Sarnolds18/Proyecto_2_Arqui/docs/evidencia.md

# Evidencia FPGA → ASIC (sección 3.1)

Construcciones del RTL del Proyecto 2 (tag `p2-entrega`) que dependen de la FPGA, el
mensaje de LibreLane que las evidenció y cómo se reemplazaron. Cada log citado debe
existir en el repo (corrida guardada en `flow/asic_top/runs/`).

## Corridas

| Corrida | RTL | Resultado |
|---|---|---|
| `00_rtl_p2_sin_cambios` | Tag `p2-entrega` + `rtl/asic_top.v` | Se detiene en la etapa 3 de 80 (`Checker.LintErrors`): 2 errores de lint (`flow.log:7`, `error.log:1`) |
| `01_regfile_ff` | `00` + register file de flip-flops (#1 resuelto) | Corrida con `--to OpenROAD.STAPrePNR` (etapas 1–12): lint y síntesis pasan sin errores. Ningún mensaje de error por #2–#5: Yosys los acepta y descarta los valores iniciales en silencio (ver detalle) |
| `02_reset_externo` | `01` + reset externo, `debounce_bank` con reset, 7-seg activo alto (#4, #5, #7) + SDC propio | `--to OpenROAD.STAPrePNR`: lint sin `PROCASSINIT` ni `rst_ni` sin usar; en síntesis el único valor inicial que queda es el de la RAM (`06-yosys-synthesis/yosys-synthesis.log:1085`, punto 2) |

| # | Construcción | Archivo | Mensaje de LibreLane (log:línea) | Reemplazo |
|---|---|---|---|---|
| 1 | Primitiva `SB_RAM40_4K` (iCE40) | `rtl/espino_core/espino_register_file.v` | `flow/asic_top/runs/00_rtl_p2_sin_cambios/01-verilator-lint/verilator-lint.log:1` y `:13` (`%Error-MODMISSING`) | Banco de 15×32 flip-flops con lectura sincrónica y reset a 0 |
| 2 | `initial $readmemh` | `rtl/pochoco_ram.v` | `flow/asic_top/runs/01_regfile_ff/06-yosys-synthesis/yosys-synthesis.log:1093` (`meminit`) y `:4102`–`4106` (`DFFLEGALIZE`); sin warning | El programa queda en el circuito: ROM combinacional `game_rom` generada por `sw/assembler.py --rom` (estrategia 1) o valores de reset de los flip-flops (estrategia 2); `pochoco_ram.v` eliminado (ver `docs/memoria.md`) |
| 3 | Inferencia de BRAM (512 palabras) | `rtl/pochoco_ram.v` | `flow/asic_top/runs/01_regfile_ff/06-yosys-synthesis/yosys-synthesis.log:1401`–`1406` (`MEMORY_MAP`) y `:4532`, `:4558` (estadísticas) | Memoria dimensionada al uso real (99 palabras de instrucción, 0 de datos): `pochoco_mem_rom` (ROM + 8 palabras de datos) o `pochoco_mem_ff` (107 palabras de flip-flops) |
| 4 | Reset de encendido por valor inicial (`reg [12:0] por_cnt = 13'b0`) | `rtl/pochoco_soc.v` | `flow/asic_top/runs/01_regfile_ff/01-verilator-lint/verilator-lint.log:7` (`%Warning-PROCASSINIT`), `flow/asic_top/runs/01_regfile_ff/06-yosys-synthesis/yosys-synthesis.log:304`–`305` (`PROC_INIT`) y `:4102`–`4106`; además `verilator-lint.log:1` (`rst_ni` sin usar) | Puerto `rst_ni` en `asic_top` → sincronizador de 2 FF en `pochoco_soc` (aserción asíncrona, liberación sincrónica); `por_cnt` eliminado |
| 5 | Bloque `initial` y registros sin reset | `rtl/debouncer.v` | `flow/asic_top/runs/01_regfile_ff/06-yosys-synthesis/yosys-synthesis.log:299`–`303` (`PROC_INIT`) y `:4102`–`4106`; sin warning | Reset asíncrono a 0 en `debounce_bank`; `initial` eliminado |
| 6 | Supuesto de reloj de 25 MHz (`TICK_BITS`, constantes de `game.s`) | `rtl/debouncer.v`, `sw/game.s` | Sin mensaje (no es un error de síntesis, ver detalle) | `TICK_BITS` 18 → 17 (~13 ms a 10 MHz); constantes de `game.s` recalculadas para 10 MHz (P3-07) |
| 7 | Inversión `~seg` para displays activo-bajo de la Go Board | `rtl/pochoco_soc.v` | Sin mensaje (ver detalle) | Salidas activo alto en `pochoco_soc`/`asic_top`; la inversión queda solo en `game_top` |
| 8 | Botones asíncronos sin sincronizador | `rtl/debouncer.v` | Sin mensaje (ver detalle) | Sincronizador de 2 FF por botón dentro de `debounce_bank` |

## Detalle por construcción

Para cada fila: extracto del mensaje, explicación de por qué es un problema en ASIC y
descripción del cambio. Si una construcción no produjo ningún mensaje del flujo, se
explica por qué igual era un problema.

### 1. `SB_RAM40_4K`

Corrida `00_rtl_p2_sin_cambios`, `01-verilator-lint/verilator-lint.log`:

```
1:  %Error-MODMISSING: .../rtl/espino_core/espino_register_file.v:22:3: Cannot find file containing module: 'SB_RAM40_4K'
13: %Error-MODMISSING: .../rtl/espino_core/espino_register_file.v:33:3: Cannot find file containing module: 'SB_RAM40_4K'
16: %Error: Exiting due to 2 error(s)
```

`SB_RAM40_4K` es un bloque de RAM físico de la iCE40, instanciado directamente en el
banco de registros (dos copias para tener dos puertos de lectura). En el ASIC no existe:
la biblioteca `gf180mcu_fd_sc_mcu7t5v0` solo tiene celdas estándar y el proyecto no usa
macros SRAM. Verilator no encuentra el módulo y LibreLane detiene el flujo en
`Checker.LintErrors` antes de llegar a síntesis, por lo que esta corrida no alcanza a
mostrar las demás construcciones de la tabla.

Reemplazo: `espino_register_file` reescrito con flip-flops (mismo nombre de módulo y
puertos, instancia `u_rf` sin cambios):

- x1..x15 como 15 registros de 32 bits; x0 no se almacena y se lee como 0.
- **Lectura sincrónica**: `rdata_a_o`/`rdata_b_o` son registros, igual que la salida
  de `SB_RAM40_4K`. El core depende de esa latencia de un ciclo (FSM `ops_valid_q` en
  `espino_id_stage.v`), así que no se cambió a lectura combinacional.
- **Reset a 0** con `rst_ni`, para reproducir el `INIT_0 = 0` de las BRAM: en la FPGA
  los registros arrancaban en 0 y en ASIC los flip-flops arrancan indeterminados.
- Costo: 15×32 + 2×32 = 544 flip-flops (antes, 0 FF y 4 BRAM).

Verificación: `sim/tb_register_file.v` (reset, x0, lectura sincrónica,
read-before-write y 2000 accesos aleatorios contra un modelo de referencia) pasa, y
`sim/tb_game_smoke.v` da exactamente la misma salida y los mismos tiempos que con el
modelo `SB_RAM40_4K` de `cells_sim.v`.

### 2. `initial $readmemh`

Corrida `01_regfile_ff`, `06-yosys-synthesis/yosys-synthesis.log`:

```
1093: Removed top 23 address bits (of 32) from memory init port asic_top.$flatten\u_pochoco.\u_ram.$meminit$\mem$.../rtl/pochoco_ram.v:36$123 (u_pochoco.u_ram.mem).
4102: 155.1. Executing DFFLEGALIZE pass (convert FFs to types supported by the target).
4103: Mapping DFF cells in module `\asic_top':
4104:   mapped 738 $_DFF_PN0_ cells to \gf180mcu_fd_sc_mcu7t5v0__dffrnq_1 cells.
4105:   mapped 3 $_DFF_PN1_ cells to \gf180mcu_fd_sc_mcu7t5v0__dffsnq_1 cells.
4106:   mapped 16488 $_DFF_P_ cells to \gf180mcu_fd_sc_mcu7t5v0__dffq_1 cells.
```

Yosys sí lee `game.hex` (resuelve la ruta relativa al archivo fuente) y lo guarda como
puerto de inicialización de la memoria (`meminit`, línea 1093). Pero al convertir la
memoria a flip-flops ese contenido solo puede quedar como valor inicial de cada FF, y
las celdas de GF180 no tienen valor inicial: `DFFLEGALIZE` mapea los 16.488 FF sin reset
a `dffq_1` (línea 4106) y el contenido del programa desaparece del netlist **sin ningún
warning ni error** (`warning.log` solo tiene los avisos de lint y de SDC). En la FPGA el
bitstream carga el contenido de la BRAM al configurarse; en el silicio no hay ningún
mecanismo que lo haga, así que el SoC arrancaría ejecutando memoria indeterminada.

Reemplazo: el programa ya no se carga desde un archivo. `sw/assembler.py --rom` genera
`rtl/game_rom.v` desde `game.s`; la estrategia 1 lo usa como ROM y la 2 como valores de
reset de los flip-flops. Detalle y comparación en `docs/memoria.md`.

### 3. Inferencia de BRAM

Corrida `01_regfile_ff`, `06-yosys-synthesis/yosys-synthesis.log`:

```
1401: Mapping memory \u_pochoco.u_ram.mem in module \asic_top:
1402:   created 512 $dff cells and 0 static cells of width 32.
1405:   read interface: 2 $dff and 1022 $mux cells.
1406:   write interface: 2048 write mux blocks.
4532:     16488 1.05E+06   gf180mcu_fd_sc_mcu7t5v0__dffq_1
4558:    Chip area for module '\asic_top': 2312311.724800
4559:      of which used for sequential elements: 1104958.310400 (47.79%)
```

En la iCE40 la RAM de 512×32 se infería como bloques BRAM (0 LUT/FF). Sin macros SRAM
no hay donde inferirla: `MEMORY_MAP` la convierte en 512×32 = 16.384 flip-flops más
sus multiplexores de lectura y escritura. El diseño completo queda en 67.817 celdas y
2,31 mm² de área de celdas, casi la mitad en elementos secuenciales. No es un error del
flujo, pero el área se dispara y casi toda es memoria que el juego no usa: el
programa ocupa 99 palabras de instrucción y 0 de datos.

Reemplazo: memoria dimensionada al uso real del juego (99 palabras de instrucción y 0
de datos, contadas con `scripts/contar_palabras.py`). Ver `docs/memoria.md`.

### 4. Reset de encendido por valor inicial

Corrida `01_regfile_ff`:

```
01-verilator-lint/verilator-lint.log:
1: %Warning-UNUSEDSIGNAL: rtl/asic_top.v:22:21: Signal is not used: 'rst_ni'
7: %Warning-PROCASSINIT: rtl/pochoco_soc.v:38:25: Procedural assignment to declaration with initial value: 'por_cnt'

06-yosys-synthesis/yosys-synthesis.log:
304: Found init rule in `$paramod$...\pochoco_soc.$proc$rtl/pochoco_soc.v:38$20'.
305:   Set init value: \por_cnt = 13'0000000000000
```

Verilator avisa que `por_cnt` tiene valor inicial en la declaración y además se asigna
en un `always`. Yosys lo convierte en un atributo `init` (línea 305), que se pierde en
`DFFLEGALIZE` (líneas 4102–4106) igual que en el punto 2. En la FPGA todos los FF valen
0 después de configurar, así que `por_cnt` contaba de 0 a 4096 y soltaba el reset. En
el ASIC arranca en un valor indeterminado: si `por_cnt[12]` arranca en 1 el SoC nunca
pasa por reset, y en simulación queda en X y el reset no se suelta nunca. El warning
de la línea 1 muestra la otra cara del problema: `asic_top` tiene un puerto `rst_ni`
que todavía no llega a ningún lado.

Reemplazo:

- `asic_top` lleva su puerto `rst_ni` (asíncrono, activo bajo) a un nuevo puerto
  `i_Rst_n` de `pochoco_soc`.
- `pochoco_soc` lo pasa por un **sincronizador de 2 flip-flops**: el reset se aplica
  apenas baja `i_Rst_n` (asíncrono, no necesita reloj) y se libera dos flancos de reloj
  después de que sube, sincronizado con `clk`. Así todos los FF del SoC salen de reset
  en el mismo flanco y no hay violaciones de *recovery/removal* (la liberación de un
  reset asíncrono se comporta como una entrada de datos respecto del reloj).
- `por_cnt` se eliminó sin reemplazo de espera: los 4096 ciclos existían porque las BRAM
  de la iCE40 necesitan tiempo tras la configuración, y en el ASIC no hay BRAM.

Verificación: lint de Verilator sin `PROCASSINIT` ni `rst_ni` sin usar;
`sim/tb_game_smoke.v` (que ahora maneja `i_Rst_n`) pasa con el mismo resultado que
antes, con todos los eventos adelantados exactamente 4090 ciclos (reset de 4096 ciclos →
~6 ciclos: 4 del testbench + 2 del sincronizador). En la corrida `02_reset_externo` ya no aparece
el warning `PROCASSINIT` ni la regla `PROC_INIT` de `por_cnt`; el único valor inicial
que queda en `06-yosys-synthesis/yosys-synthesis.log` es el de la RAM (línea 1085). Como en simulación todos los FF
arrancan en X, esto también muestra que el SoC ya no depende de valores iniciales
(salvo el contenido de la RAM, punto 2).

### 5. `initial` en `debounce_bank`

Corrida `01_regfile_ff`, `06-yosys-synthesis/yosys-synthesis.log`:

```
299: Found init rule in `$paramod\debounce_bank\TICK_BITS=s32'00000000000000000000000000010010.$proc$rtl/debouncer.v:36$130'.
300:   Set init value: \btn_estable = 4'0000
301:   Set init value: \tick_cnt = 18'000000000000000000
302:   Set init value: \tick_bit_prev = 1'0
303:   Set init value: \btn_prev_sample = 4'0000
```

El bloque `initial` es la única inicialización de estos registros (no tienen reset).
Yosys lo acepta sin warning y los valores se pierden en `DFFLEGALIZE`. La consecuencia
es más leve que en el punto 4 (`tick_cnt` es de libre corrida y `btn_estable` se
corrige en el primer muestreo), pero hasta los primeros dos muestreos de `tick` el SoC puede
leer botones falsos, y en simulación del netlist los registros quedan en X.

Reemplazo: `debounce_bank` recibe `rst_ni` (el mismo reset sincronizado del SoC, vía
`pochoco_periph`) y sus cuatro registros tienen reset asíncrono a 0; el bloque
`initial` se eliminó. Verificación: `sim/tb_pochoco_periph.v` pasa.

### 6. Supuesto de reloj de 25 MHz

No produce ningún mensaje: para la síntesis un contador de 18 bits o una constante de
75.000.000 son igual de válidos. El problema es de comportamiento. El diseño corre en el
ASIC con `CLOCK_PERIOD` = 100 ns (10 MHz), no con los 25 MHz del oscilador de la Go Board,
y todo lo que mide tiempo contando ciclos queda 2,5 veces más lento:

- `debounce_bank` con `TICK_BITS=18` muestrea cada 2^18 / 10 MHz ≈ 26,2 ms (antes
  ~10,5 ms a 25 MHz).
- En `game.s`, los 3 s de espera (75.000.000 ciclos) pasarían a durar 7,5 s, y cada
  décima medida (2.500.000 ciclos) pasaría a valer 0,25 s, así que el tiempo de reacción
  mostrado quedaría mal.

Reemplazo:

- `TICK_BITS` por defecto 18 → **17** en `debounce_bank` y en `DEBOUNCE_TICK_BITS` de
  `pochoco_periph`: 2^17 / 10 MHz ≈ 13,1 ms, cerca de la ventana de ~10 ms del
  Proyecto 1.
- Constantes de `game.s` para 10 MHz (P3-07): 3 s = 30.000.000 ciclos, 2 s =
  20.000.000 y 1 décima = 1.000.000 (cálculo en la cabecera de `sw/game.s`).

### 7. Inversión de los 7 segmentos

No produce ningún mensaje: un inversor es lógica perfectamente sintetizable. El problema
es que la polaridad activo bajo es propiedad de los displays de la Go Board,
no del SoC. `asic_top` es un macro cuyas salidas son terminales lógicos, sin saber qué
display (ni qué driver) va a conectarse, así que dejar la inversión adentro fijaría una
convención de la placa en el silicio.

Reemplazo: `pochoco_soc` (y por lo tanto `asic_top`) entrega los segmentos **activo
alto**, `{G,F,E,D,C,B,A}`, tal como los produce `hex2seg`. La inversión `~seg` se movió a
`game_top`, el top de la FPGA, que es el que conoce la placa.

### 8. Botones sin sincronizador

No produce ningún mensaje: el flujo no puede saber que `btn_i` viene de un botón
mecánico, asíncrono al reloj. En el Proyecto 2 (y en el debouncer del Proyecto 1) los
botones entraban directo a la lógica de muestreo, que los comparaba y guardaba en el
mismo flanco. Si un botón cambia justo en la ventana de setup/hold de esos flip-flops,
pueden quedar metaestables o tomar valores distintos para el mismo botón (uno lo ve
apretado y otro no). En la FPGA nunca se observó una falla, pero en el ASIC no hay nada
que lo garantice, y el STA no lo puede verificar porque la entrada no tiene una relación
de tiempo real con `clk`.

Reemplazo: cada bit de `btn_i` pasa por **2 flip-flops en cadena** (`btn_meta` →
`btn_sync`, con reset a 0) antes del muestreo de `debounce_bank`. Si el primero queda
metaestable, tiene un ciclo completo para estabilizarse antes de que lo lea el resto del
circuito. Costo: 8 flip-flops. Las entradas SPI ya tenían un sincronizador equivalente
(3 FF en `pochoco_spi_slave`).

Efecto en el comportamiento: el sincronizador agrega 2 ciclos, pero como `btn_estable`
solo cambia en los pulsos de `tick`, la latencia queda cuantizada al período de
muestreo. Comparando el debouncer anterior con el nuevo en 32 posiciones de la pulsación
(`TICK_BITS=4`), en 28 la latencia es idéntica y en 4 (2 de cada 16 ciclos del período)
aumenta en un período de muestreo, ~13 ms en el ASIC: imperceptible para el jugador.
`sim/tb_pochoco_periph.v` y `sim/tb_game_smoke.v` pasan. En el segundo cambian el
promedio final y la secuencia de LEDs, porque el juego mide tiempos en ciclos y siembra
su generador pseudoaleatorio con el contador de ciclos, así que cualquier corrimiento
cambia ambos.
