Sarnolds18/Proyecto_2_Arqui/docs/img/layout.png

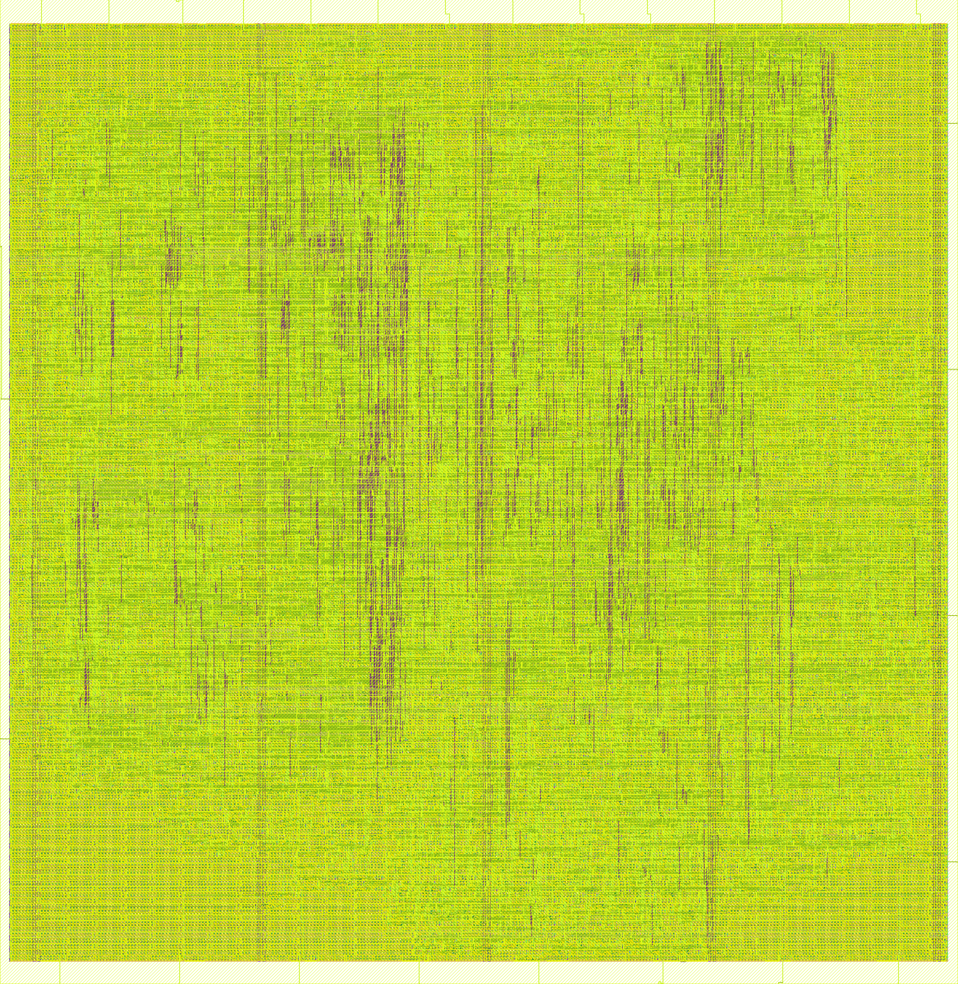
docs/img/layout.png
