Sarnolds18/Proyecto_2_Arqui/flow/asic_top/runs/CP100_U40_prueba/final/metrics.csv

Metric | Value
design__lint_error__count | 0
design__lint_timing_construct__count | 0
design__lint_warning__count | 14
design__inferred_latch__count | 0
design__instance__count | 22288
design__instance__area | 409701
design__instance_unmapped__count | 0
synthesis__check_error__count | 0
design__max_slew_violation__count__corner:nom_tt_025C_5v00 | 49
design__max_fanout_violation__count__corner:nom_tt_025C_5v00 | 70
design__max_cap_violation__count__corner:nom_tt_025C_5v00 | 4
power__internal__total | 0.010003937408328056
power__switching__total | 0.0028003505431115627
power__leakage__total | 0.000002398744527454255
power__total | 0.012806687504053116
clock__skew__worst_hold__corner:nom_tt_025C_5v00 | -0.5646928640080007
clock__skew__worst_setup__corner:nom_tt_025C_5v00 | 0.3935950288208354
timing__hold__ws__corner:nom_tt_025C_5v00 | 0.37838089288357013
timing__setup__ws__corner:nom_tt_025C_5v00 | 67.98585353782013
timing__hold__tns__corner:nom_tt_025C_5v00 | 0.0
timing__setup__tns__corner:nom_tt_025C_5v00 | 0.0
timing__hold__wns__corner:nom_tt_025C_5v00 | 0
timing__setup__wns__corner:nom_tt_025C_5v00 | 0.0
timing__hold_vio__count__corner:nom_tt_025C_5v00 | 0
timing__hold_r2r__ws__corner:nom_tt_025C_5v00 | 0.378381
timing__hold_r2r_vio__count__corner:nom_tt_025C_5v00 | 0
timing__setup_vio__count__corner:nom_tt_025C_5v00 | 0
timing__setup_r2r__ws__corner:nom_tt_025C_5v00 | 67.985855
timing__setup_r2r_vio__count__corner:nom_tt_025C_5v00 | 0
design__max_slew_violation__count__corner:nom_ss_125C_4v50 | 2355
design__max_fanout_violation__count__corner:nom_ss_125C_4v50 | 70
design__max_cap_violation__count__corner:nom_ss_125C_4v50 | 4
clock__skew__worst_hold__corner:nom_ss_125C_4v50 | -0.7943959048756445
clock__skew__worst_setup__corner:nom_ss_125C_4v50 | 0.5025582314768442
timing__hold__ws__corner:nom_ss_125C_4v50 | 0.9426522051971984
timing__setup__ws__corner:nom_ss_125C_4v50 | 41.11415679835652
timing__hold__tns__corner:nom_ss_125C_4v50 | 0.0
timing__setup__tns__corner:nom_ss_125C_4v50 | 0.0
timing__hold__wns__corner:nom_ss_125C_4v50 | 0
timing__setup__wns__corner:nom_ss_125C_4v50 | 0.0
timing__hold_vio__count__corner:nom_ss_125C_4v50 | 0
timing__hold_r2r__ws__corner:nom_ss_125C_4v50 | 0.942652
timing__hold_r2r_vio__count__corner:nom_ss_125C_4v50 | 0
timing__setup_vio__count__corner:nom_ss_125C_4v50 | 0
timing__setup_r2r__ws__corner:nom_ss_125C_4v50 | 41.114159
timing__setup_r2r_vio__count__corner:nom_ss_125C_4v50 | 0
design__max_slew_violation__count__corner:nom_ff_n40C_5v50 | 0
design__max_fanout_violation__count__corner:nom_ff_n40C_5v50 | 70
design__max_cap_violation__count__corner:nom_ff_n40C_5v50 | 4
clock__skew__worst_hold__corner:nom_ff_n40C_5v50 | -0.46023910984979904
clock__skew__worst_setup__corner:nom_ff_n40C_5v50 | 0.34468778806818856
timing__hold__ws__corner:nom_ff_n40C_5v50 | 0.13665124973923637
timing__setup__ws__corner:nom_ff_n40C_5v50 | 75.49608440981486
timing__hold__tns__corner:nom_ff_n40C_5v50 | 0.0
timing__setup__tns__corner:nom_ff_n40C_5v50 | 0.0
timing__hold__wns__corner:nom_ff_n40C_5v50 | 0
timing__setup__wns__corner:nom_ff_n40C_5v50 | 0.0
timing__hold_vio__count__corner:nom_ff_n40C_5v50 | 0
timing__hold_r2r__ws__corner:nom_ff_n40C_5v50 | 0.136651
timing__hold_r2r_vio__count__corner:nom_ff_n40C_5v50 | 0
timing__setup_vio__count__corner:nom_ff_n40C_5v50 | 0
timing__setup_r2r__ws__corner:nom_ff_n40C_5v50 | 79.936691
timing__setup_r2r_vio__count__corner:nom_ff_n40C_5v50 | 0
design__max_slew_violation__count | 3198
design__max_fanout_violation__count | 70
design__max_cap_violation__count | 9
clock__skew__worst_hold | -0.44994045873750543
clock__skew__worst_setup | 0.33849946026506134
timing__hold__ws | 0.13378387665244212
timing__setup__ws | 38.98326038982818
timing__hold__tns | 0.0
timing__setup__tns | 0.0
timing__hold__wns | 0
timing__setup__wns | 0.0
timing__hold_vio__count | 0
timing__hold_r2r__ws | 0.133784
timing__hold_r2r_vio__count | 0
timing__setup_vio__count | 0
timing__setup_r2r__ws | 38.983261
timing__setup_r2r_vio__count | 0
design__die__bbox | 0.0 0.0 654.98 672.9
design__core__bbox | 6.72 15.68 647.92 654.64
design__io | 30
design__die__area | 440736
design__core__area | 409701
design__instance__count__stdcell | 9622
design__instance__area__stdcell | 210867
design__instance__count__macros | 0
design__instance__area__macros | 0
design__instance__count__padcells | 0
design__instance__area__padcells | 0
design__instance__count__cover | 0
design__instance__area__cover | 0
design__instance__utilization | 0.514684
design__instance__utilization__stdcell | 0.514684
design__rows | 163
design__rows:GF018hv5v_mcu_sc7 | 163
design__sites | 186635
design__sites:GF018hv5v_mcu_sc7 | 186635
design__instance__count__class:tie_cell | 1
design__instance__area__class:tie_cell | 8.7808
design__instance__count__class:buffer | 14
design__instance__area__class:buffer | 184.397
design__instance__count__class:inverter | 219
design__instance__area__class:inverter | 1923
design__instance__count__class:sequential_cell | 1096
design__instance__area__class:sequential_cell | 78313.8
design__instance__count__class:multi_input_combinational_cell | 4359
design__instance__area__class:multi_input_combinational_cell | 84212.3
flow__warnings__count | 1
flow__errors__count | 0
flow__warnings__count:ODB-0220 | 1
flow__warnings__type_count | 1
flow__warnings__count:ORD-0039 | 1
design__instance__count__class:endcap_cell | 326
design__instance__area__class:endcap_cell | 1431.27
design__instance__count__class:tap_cell | 2642
design__instance__area__class:tap_cell | 11599.4
design__power_grid_violation__count__net:VSS | 0
design__power_grid_violation__count__net:VDD | 0
design__power_grid_violation__count | 0
floorplan__design__io | 28
design__io__hpwl | 5834598
flow__warnings__count:GRT-0281 | 1
timing__drv__floating__nets | 2
timing__drv__floating__pins | 0
design__instance__displacement__total | 349.128
design__instance__displacement__mean | 0.036
design__instance__displacement__max | 45.166
route__wirelength__estimated | 361710
design__violations | 0
design__instance__count__class:timing_repair_buffer | 820
design__instance__area__class:timing_repair_buffer | 26932.9
flow__warnings__count:RSZ-0020 | 1
flow__warnings__count:STA-1140 | 6
design__instance__count__class:clock_buffer | 99
design__instance__area__class:clock_buffer | 5571.42
design__instance__count__class:clock_inverter | 41
design__instance__area__class:clock_inverter | 667.341
design__instance__count__setup_buffer | 0
design__instance__count__hold_buffer | 7
global_route__vias | 13
global_route__wirelength | 596005
antenna__violating__nets | 0
antenna__violating__pins | 0
route__antenna_violation__count | 0
antenna_diodes_count | 5
route__net | 6599
route__net__special | 2
route__drc_errors__iter:0 | 18
route__wirelength__iter:0 | 426161
route__drc_errors__iter:1 | 0
route__wirelength__iter:1 | 426155
route__drc_errors__iter:2 | 2
route__wirelength__iter:2 | 426136
route__drc_errors__iter:3 | 0
route__wirelength__iter:3 | 426135
route__drc_errors__iter:4 | 0
route__wirelength__iter:4 | 426100
route__drc_errors | 0
route__wirelength | 426155
route__vias | 49693
route__vias__singlecut | 49693
route__vias__multicut | 0
design__instance__count__class:antenna_cell | 5
design__instance__area__class:antenna_cell | 21.952
flow__warnings__count:DRT-0349 | 8
design__disconnected_pin__count | 0
design__critical_disconnected_pin__count | 0
route__wirelength__max | 1338.95
design__instance__count__class:fill_cell | 12666
design__instance__area__class:fill_cell | 198835
timing__unannotated_net__count__corner:nom_tt_025C_5v00 | 59
timing__unannotated_net_filtered__count__corner:nom_tt_025C_5v00 | 0
timing__unannotated_net__count__corner:nom_ss_125C_4v50 | 59
timing__unannotated_net_filtered__count__corner:nom_ss_125C_4v50 | 0
timing__unannotated_net__count__corner:nom_ff_n40C_5v50 | 59
timing__unannotated_net_filtered__count__corner:nom_ff_n40C_5v50 | 0
design__max_slew_violation__count__corner:min_tt_025C_5v00 | 5
design__max_fanout_violation__count__corner:min_tt_025C_5v00 | 70
design__max_cap_violation__count__corner:min_tt_025C_5v00 | 1
clock__skew__worst_hold__corner:min_tt_025C_5v00 | -0.5500857702821932
clock__skew__worst_setup__corner:min_tt_025C_5v00 | 0.3852116790136423
timing__hold__ws__corner:min_tt_025C_5v00 | 0.3742860571860353
timing__setup__ws__corner:min_tt_025C_5v00 | 69.00741506876888
timing__hold__tns__corner:min_tt_025C_5v00 | 0.0
timing__setup__tns__corner:min_tt_025C_5v00 | 0.0
timing__hold__wns__corner:min_tt_025C_5v00 | 0
timing__setup__wns__corner:min_tt_025C_5v00 | 0.0
timing__hold_vio__count__corner:min_tt_025C_5v00 | 0
timing__hold_r2r__ws__corner:min_tt_025C_5v00 | 0.374286
timing__hold_r2r_vio__count__corner:min_tt_025C_5v00 | 0
timing__setup_vio__count__corner:min_tt_025C_5v00 | 0
timing__setup_r2r__ws__corner:min_tt_025C_5v00 | 69.007416
timing__setup_r2r_vio__count__corner:min_tt_025C_5v00 | 0
timing__unannotated_net__count__corner:min_tt_025C_5v00 | 59
timing__unannotated_net_filtered__count__corner:min_tt_025C_5v00 | 0
design__max_slew_violation__count__corner:min_ss_125C_4v50 | 1786
design__max_fanout_violation__count__corner:min_ss_125C_4v50 | 70
design__max_cap_violation__count__corner:min_ss_125C_4v50 | 1
clock__skew__worst_hold__corner:min_ss_125C_4v50 | -0.7705072353791672
clock__skew__worst_setup__corner:min_ss_125C_4v50 | 0.48793970245355966
timing__hold__ws__corner:min_ss_125C_4v50 | 0.9356535810966317
timing__setup__ws__corner:min_ss_125C_4v50 | 42.89165055640494
timing__hold__tns__corner:min_ss_125C_4v50 | 0.0
timing__setup__tns__corner:min_ss_125C_4v50 | 0.0
timing__hold__wns__corner:min_ss_125C_4v50 | 0
timing__setup__wns__corner:min_ss_125C_4v50 | 0.0
timing__hold_vio__count__corner:min_ss_125C_4v50 | 0
timing__hold_r2r__ws__corner:min_ss_125C_4v50 | 0.935654
timing__hold_r2r_vio__count__corner:min_ss_125C_4v50 | 0
timing__setup_vio__count__corner:min_ss_125C_4v50 | 0
timing__setup_r2r__ws__corner:min_ss_125C_4v50 | 42.891651
timing__setup_r2r_vio__count__corner:min_ss_125C_4v50 | 0
timing__unannotated_net__count__corner:min_ss_125C_4v50 | 59
timing__unannotated_net_filtered__count__corner:min_ss_125C_4v50 | 0
design__max_slew_violation__count__corner:min_ff_n40C_5v50 | 0
design__max_fanout_violation__count__corner:min_ff_n40C_5v50 | 70
design__max_cap_violation__count__corner:min_ff_n40C_5v50 | 1
clock__skew__worst_hold__corner:min_ff_n40C_5v50 | -0.44994045873750543
clock__skew__worst_setup__corner:min_ff_n40C_5v50 | 0.33849946026506134
timing__hold__ws__corner:min_ff_n40C_5v50 | 0.13378387665244212
timing__setup__ws__corner:min_ff_n40C_5v50 | 75.55459050033201
timing__hold__tns__corner:min_ff_n40C_5v50 | 0.0
timing__setup__tns__corner:min_ff_n40C_5v50 | 0.0
timing__hold__wns__corner:min_ff_n40C_5v50 | 0
timing__setup__wns__corner:min_ff_n40C_5v50 | 0.0
timing__hold_vio__count__corner:min_ff_n40C_5v50 | 0
timing__hold_r2r__ws__corner:min_ff_n40C_5v50 | 0.133784
timing__hold_r2r_vio__count__corner:min_ff_n40C_5v50 | 0
timing__setup_vio__count__corner:min_ff_n40C_5v50 | 0
timing__setup_r2r__ws__corner:min_ff_n40C_5v50 | 80.607292
timing__setup_r2r_vio__count__corner:min_ff_n40C_5v50 | 0
timing__unannotated_net__count__corner:min_ff_n40C_5v50 | 59
timing__unannotated_net_filtered__count__corner:min_ff_n40C_5v50 | 0
design__max_slew_violation__count__corner:max_tt_025C_5v00 | 92
design__max_fanout_violation__count__corner:max_tt_025C_5v00 | 70
design__max_cap_violation__count__corner:max_tt_025C_5v00 | 9
clock__skew__worst_hold__corner:max_tt_025C_5v00 | -0.5824522140567784
clock__skew__worst_setup__corner:max_tt_025C_5v00 | 0.40406198974842233
timing__hold__ws__corner:max_tt_025C_5v00 | 0.3834906944989225
timing__setup__ws__corner:max_tt_025C_5v00 | 66.7607641398841
timing__hold__tns__corner:max_tt_025C_5v00 | 0.0
timing__setup__tns__corner:max_tt_025C_5v00 | 0.0
timing__hold__wns__corner:max_tt_025C_5v00 | 0
timing__setup__wns__corner:max_tt_025C_5v00 | 0.0
timing__hold_vio__count__corner:max_tt_025C_5v00 | 0
timing__hold_r2r__ws__corner:max_tt_025C_5v00 | 0.383491
timing__hold_r2r_vio__count__corner:max_tt_025C_5v00 | 0
timing__setup_vio__count__corner:max_tt_025C_5v00 | 0
timing__setup_r2r__ws__corner:max_tt_025C_5v00 | 66.760765
timing__setup_r2r_vio__count__corner:max_tt_025C_5v00 | 0
timing__unannotated_net__count__corner:max_tt_025C_5v00 | 59
timing__unannotated_net_filtered__count__corner:max_tt_025C_5v00 | 0
design__max_slew_violation__count__corner:max_ss_125C_4v50 | 3198
design__max_fanout_violation__count__corner:max_ss_125C_4v50 | 70
design__max_cap_violation__count__corner:max_ss_125C_4v50 | 9
clock__skew__worst_hold__corner:max_ss_125C_4v50 | -0.823492408683321
clock__skew__worst_setup__corner:max_ss_125C_4v50 | 0.5202314282164744
timing__hold__ws__corner:max_ss_125C_4v50 | 0.9514127532876758
timing__setup__ws__corner:max_ss_125C_4v50 | 38.98326038982818
timing__hold__tns__corner:max_ss_125C_4v50 | 0.0
timing__setup__tns__corner:max_ss_125C_4v50 | 0.0
timing__hold__wns__corner:max_ss_125C_4v50 | 0
timing__setup__wns__corner:max_ss_125C_4v50 | 0.0
timing__hold_vio__count__corner:max_ss_125C_4v50 | 0
timing__hold_r2r__ws__corner:max_ss_125C_4v50 | 0.951413
timing__hold_r2r_vio__count__corner:max_ss_125C_4v50 | 0
timing__setup_vio__count__corner:max_ss_125C_4v50 | 0
timing__setup_r2r__ws__corner:max_ss_125C_4v50 | 38.983261
timing__setup_r2r_vio__count__corner:max_ss_125C_4v50 | 0
timing__unannotated_net__count__corner:max_ss_125C_4v50 | 59
timing__unannotated_net_filtered__count__corner:max_ss_125C_4v50 | 0
design__max_slew_violation__count__corner:max_ff_n40C_5v50 | 0
design__max_fanout_violation__count__corner:max_ff_n40C_5v50 | 70
design__max_cap_violation__count__corner:max_ff_n40C_5v50 | 8
clock__skew__worst_hold__corner:max_ff_n40C_5v50 | -0.4727385283704734
clock__skew__worst_setup__corner:max_ff_n40C_5v50 | 0.3535985770937225
timing__hold__ws__corner:max_ff_n40C_5v50 | 0.14022450264505093
timing__setup__ws__corner:max_ff_n40C_5v50 | 75.42441906745927
timing__hold__tns__corner:max_ff_n40C_5v50 | 0.0
timing__setup__tns__corner:max_ff_n40C_5v50 | 0.0
timing__hold__wns__corner:max_ff_n40C_5v50 | 0
timing__setup__wns__corner:max_ff_n40C_5v50 | 0.0
timing__hold_vio__count__corner:max_ff_n40C_5v50 | 0
timing__hold_r2r__ws__corner:max_ff_n40C_5v50 | 0.140225
timing__hold_r2r_vio__count__corner:max_ff_n40C_5v50 | 0
timing__setup_vio__count__corner:max_ff_n40C_5v50 | 0
timing__setup_r2r__ws__corner:max_ff_n40C_5v50 | 79.130203
timing__setup_r2r_vio__count__corner:max_ff_n40C_5v50 | 0
timing__unannotated_net__count__corner:max_ff_n40C_5v50 | 59
timing__unannotated_net_filtered__count__corner:max_ff_n40C_5v50 | 0
timing__unannotated_net__count | 59
timing__unannotated_net_filtered__count | 0
design_powergrid__voltage__worst__net:VDD__corner:nom_tt_025C_5v00 | 4.99984
design_powergrid__drop__average__net:VDD__corner:nom_tt_025C_5v00 | 4.99998
design_powergrid__drop__worst__net:VDD__corner:nom_tt_025C_5v00 | 0.000155769
design_powergrid__voltage__worst__net:VSS__corner:nom_tt_025C_5v00 | 0.0000856946
design_powergrid__drop__average__net:VSS__corner:nom_tt_025C_5v00 | 0.000024069
design_powergrid__drop__worst__net:VSS__corner:nom_tt_025C_5v00 | 0.0000856946
design_powergrid__voltage__worst | 0.0000856946
design_powergrid__voltage__worst__net:VDD | 4.99984
design_powergrid__drop__worst | 0.000155769
design_powergrid__drop__worst__net:VDD | 0.000155769
design_powergrid__voltage__worst__net:VSS | 0.0000856946
design_powergrid__drop__worst__net:VSS | 0.0000856946
ir__voltage__worst | 5
ir__drop__avg | 0.00002500000000000000119804340059648239957823534496128559112548828125
ir__drop__worst | 0.000155999999999999997175870181109758050297386944293975830078125
design__xor_difference__count | 0
magic__drc_error__count | 0
magic__illegal_overlap__count | 0
design__lvs_device_difference__count | 0
design__lvs_net_difference__count | 0
design__lvs_property_fail__count | 0
design__lvs_error__count | 0
design__lvs_unmatched_device__count | 0
design__lvs_unmatched_net__count | 0
design__lvs_unmatched_pin__count | 0
