Sarnolds18/Proyecto_2_Arqui/results/floorplan.csv

corrida | estado | cierra | clock_period_ns | fp_core_util | setup_ws_tt | setup_tns_tt | hold_ws_tt | hold_tns_tt | setup_ws_ss | setup_tns_ss | hold_ws_ss | hold_tns_ss | setup_ws_peor | setup_tns_peor | hold_ws_peor | hold_tns_peor | setup_r2r_ws_tt | setup_r2r_ws_ss | fmax_r2r_mhz | area_stdcell_um2 | area_core_um2 | area_die_um2 | utilizacion | celdas_stdcell | flip_flops | drc_magic | lvs_errores | antena_redes | antena_pines | max_cap_viol | max_slew_viol | max_fanout_viol | grt_uso_pct | grt_overflow | drt_viol_iter0 | die_mm2 | costo_usd
CP100_U40_final | completa | si | 100 | 40 | 73.95011390333443 | 0 | 0.39018123170144237 | 0 | 51.39745130533921 | 0 | 0.9700922562052865 | 0 | 51.39745130533921 | 0 | 0.14260837359094652 | 0 | 74.027802 | 51.397449 | 20.575 | 196097 | 408628 | 438693 | 0.479892 | 9651 | 1098 | 0 | 0 | 0 | 0 | 10 | 2867 | 68 | 23.34 | 0 | 51 | 0.4387 | 10090
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
