Sarnolds18/Proyecto_2_Arqui/results/memoria.csv

corrida | estado | cierra | clock_period_ns | fp_core_util | setup_ws_tt | setup_tns_tt | hold_ws_tt | hold_tns_tt | setup_ws_ss | setup_tns_ss | hold_ws_ss | hold_tns_ss | setup_ws_peor | setup_tns_peor | hold_ws_peor | hold_tns_peor | setup_r2r_ws_tt | setup_r2r_ws_ss | fmax_r2r_mhz | area_stdcell_um2 | area_core_um2 | area_die_um2 | utilizacion | celdas_stdcell | flip_flops | drc_magic | lvs_errores | antena_redes | antena_pines | max_cap_viol | max_slew_viol | max_fanout_viol
CP100_U40_rom | completa | si | 100 | 40 | 64.9572929386816 | 0 | 0.40805182610043367 | 0 | 33.303991618260014 | 0 | 1.0099599220579005 | 0 | 33.303991618260014 | 0 | 0.1515303481137699 | 0 | 64.957291 | 33.303993 | 14.993 | 211393 | 409701 | 440736 | 0.51597 | 9638 | 1096 | 0 | 0 | 0 | 0 | 8 | 3398 | 72
CP100_U40_ff | completa | no | 100 | 40 | 56.33862602569345 | 0 | 0.3619553648143002 | 0 | 16.088649090577437 | 0 | 0.922166369367436 | 0 | 16.088649090577437 | 0 | 0.1221569546759209 | 0 | 56.338627 | 16.08865 | 11.917 | 816279 | 1515070 | 1571020 | 0.538774 | 32356 | 4265 | 0 | 0 | 1 | 1 | 1397 | 14587 | 278
