Sarnolds18/Proyecto_2_Arqui/results/optimizacion.csv

corrida | estado | cierra | clock_period_ns | fp_core_util | setup_ws_tt | setup_tns_tt | hold_ws_tt | hold_tns_tt | setup_ws_ss | setup_tns_ss | hold_ws_ss | hold_tns_ss | setup_ws_peor | setup_tns_peor | hold_ws_peor | hold_tns_peor | setup_r2r_ws_tt | setup_r2r_ws_ss | fmax_r2r_mhz | area_stdcell_um2 | area_core_um2 | area_die_um2 | utilizacion | celdas_stdcell | flip_flops | drc_magic | lvs_errores | antena_redes | antena_pines | max_cap_viol | max_slew_viol | max_fanout_viol
CP60_U40_boffreg | completa | no | 60 | 40 | 26.88960952233874 | 0 | 0.353287187282084 | 0 | -2.631289038912097 | -21.13409951306727 | 0.9075060959572449 | 0 | -2.631289038912097 | -21.13409951306727 | 0.11709145096050393 | 0 | 26.88961 | -2.631289 | 15.966 | 211391 | 408628 | 438693 | 0.51732 | 9638 | 1098 | 0 | 0 | 0 | 0 | 17 | 2646 | 70
CP60_U40_jerarquia | completa | no | 60 | 40 | 26.620313817869462 | 0 | 0.3840140536475324 | 0 | -3.543192506349643 | -440.18405100187084 | 0.9583174525177028 | 0 | -3.543192506349643 | -440.18405100187084 | 0.1387143772442465 | 0 | 26.620314 | -3.543193 | 15.737 | 211325 | 408628 | 438303 | 0.517159 | 9631 | 1096 | 0 | 0 | 0 | 0 | 7 | 2748 | 72
