Sarnolds18/Proyecto_2_Arqui/results/timing.csv

corrida | estado | cierra | clock_period_ns | fp_core_util | setup_ws_tt | setup_tns_tt | hold_ws_tt | hold_tns_tt | setup_ws_ss | setup_tns_ss | hold_ws_ss | hold_tns_ss | setup_ws_peor | setup_tns_peor | hold_ws_peor | hold_tns_peor | setup_r2r_ws_tt | setup_r2r_ws_ss | fmax_r2r_mhz | area_stdcell_um2 | area_core_um2 | area_die_um2 | utilizacion | celdas_stdcell | flip_flops | drc_magic | lvs_errores | antena_redes | antena_pines | max_cap_viol | max_slew_viol | max_fanout_viol
CP100_U40_final | completa | si | 100 | 40 | 73.95011390333443 | 0 | 0.39018123170144237 | 0 | 51.39745130533921 | 0 | 0.9700922562052865 | 0 | 51.39745130533921 | 0 | 0.14260837359094652 | 0 | 74.027802 | 51.397449 | 20.575 | 196097 | 408628 | 438693 | 0.479892 | 9651 | 1098 | 0 | 0 | 0 | 0 | 10 | 2867 | 68
CP30_U40_finalmargen | completa | si | 30 | 40 | 14.701669631147263 | 0 | 0.39045801030930927 | 0 | 1.2824515146162532 | 0 | 0.9712666501539491 | 0 | 1.2824515146162532 | 0 | 0.13888801613020874 | 0 | 14.70167 | 1.282452 | 34.822 | 203960 | 408628 | 438693 | 0.499135 | 9707 | 1098 | 0 | 0 | 0 | 0 | 8 | 2489 | 68
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
