Sarnolds18/Proyecto_2_Arqui/rtl/pochoco_soc.v

// Copyright 2026 Universidad de los Andes.
// Licensed under the Solderpad Hardware License, Version 0.51 (the "License");
// you may not use this file except in compliance with the License.
// SPDX-License-Identifier: SHL-0.51
//
// Course: Arquitectura de Computadores (2026)
// 
// Authors:
// - Nicolás Villegas <navillegas@miuandes.cl>

// Proyecto 3: el programa ya no se carga con $readmemh. MemStrategy elige
// la memoria (seccion 3.2): "rom" = pochoco_mem_rom (game_rom + RAM de datos
// de DataWords palabras), "ff" = pochoco_mem_ff (memoria unificada de
// NumWords palabras de flip-flops cargada en el reset).
module pochoco_soc #(
  parameter MemStrategy = "rom",
  parameter DataWords   = 8,
  parameter NumWords    = 107
) (
  input  wire       i_Clk,
  input  wire       i_Rst_n,  // asynchronous, active low

  output wire [3:0] o_LED,
  input  wire [3:0] i_Switch,

  output wire       o_Segment1_A, o_Segment1_B, o_Segment1_C, o_Segment1_D,
  output wire       o_Segment1_E, o_Segment1_F, o_Segment1_G,
  output wire       o_Segment2_A, o_Segment2_B, o_Segment2_C, o_Segment2_D,
  output wire       o_Segment2_E, o_Segment2_F, o_Segment2_G,

  input  wire       i_SPI_SCLK,
  input  wire       i_SPI_MOSI,
  input  wire       i_SPI_CS_n,
  output wire       o_SPI_MISO
);

  wire clk;
  assign clk = i_Clk;

  // Reset synchronizer: asserts asynchronously with i_Rst_n and deasserts
  // synchronously two clock edges after i_Rst_n rises, so every flip-flop
  // leaves reset on the same edge (no recovery/removal violations).
  reg  [1:0] rst_sync_q;
  wire       rst_ni;
  always @(posedge clk or negedge i_Rst_n) begin
    if (!i_Rst_n) rst_sync_q <= 2'b00;
    else          rst_sync_q <= {rst_sync_q[0], 1'b1};
  end
  assign rst_ni = rst_sync_q[1];

  // Core-memory wiring
  wire        instr_req;
  wire [31:0] instr_addr, instr_rdata;

  wire        data_req, data_we;
  wire [3:0]  data_be;
  wire [31:0] data_addr, data_wdata, data_rdata;

  espino_core #(.BootAddr(32'h0000_0000)) u_core (
    .clk_i         (clk),
    .rst_ni        (rst_ni),
    .instr_req_o   (instr_req),
    .instr_addr_o  (instr_addr),
    .instr_rdata_i (instr_rdata),
    .data_req_o    (data_req),
    .data_we_o     (data_we),
    .data_be_o     (data_be),
    .data_addr_o   (data_addr),
    .data_wdata_o  (data_wdata),
    .data_rdata_i  (data_rdata)
  );

  wire is_mmio, spi_sel, per_sel;
  assign is_mmio = data_addr[31];
  assign per_sel = is_mmio & ~data_addr[16];
  assign spi_sel = is_mmio &  data_addr[16];

  wire ram_b_req, per_req, spi_req;
  assign ram_b_req = data_req & ~is_mmio;
  assign per_req   = data_req &  per_sel;
  assign spi_req   = data_req &  spi_sel;

  wire [31:0] ram_b_rdata, per_rdata, spi_rdata;

  reg rd_is_per, rd_is_spi;
  always @(posedge clk or negedge rst_ni) begin
    if (!rst_ni) begin
      rd_is_per <= 1'b0;
      rd_is_spi <= 1'b0;
    end else if (data_req & ~data_we) begin
      rd_is_per <= per_sel;
      rd_is_spi <= spi_sel;
    end
  end
  assign data_rdata = rd_is_per ? per_rdata :
                      rd_is_spi ? spi_rdata : ram_b_rdata;

  generate
    if (MemStrategy == "ff") begin : g_mem_ff
      pochoco_mem_ff #(.NumWords(NumWords)) u_ram (
        .clk_i     (clk),
        .rst_ni    (rst_ni),
        .a_req_i   (instr_req),
        .a_addr_i  (instr_addr),
        .a_rdata_o (instr_rdata),
        .b_req_i   (ram_b_req),
        .b_we_i    (data_we),
        .b_be_i    (data_be),
        .b_addr_i  (data_addr),
        .b_wdata_i (data_wdata),
        .b_rdata_o (ram_b_rdata)
      );
    end else begin : g_mem_rom
      pochoco_mem_rom #(.DataWords(DataWords)) u_ram (
        .clk_i     (clk),
        .a_req_i   (instr_req),
        .a_addr_i  (instr_addr),
        .a_rdata_o (instr_rdata),
        .b_req_i   (ram_b_req),
        .b_we_i    (data_we),
        .b_be_i    (data_be),
        .b_addr_i  (data_addr),
        .b_wdata_i (data_wdata),
        .b_rdata_o (ram_b_rdata)
      );
    end
  endgenerate

  // Peripherals
  wire [6:0] seg1, seg2;

  pochoco_periph u_periph (
    .clk_i     (clk),
    .rst_ni    (rst_ni),
    .sel_i     (per_sel),
    .req_i     (per_req),
    .we_i      (data_we),
    .addr_i    (data_addr[7:0]),
    .wdata_i   (data_wdata),
    .rdata_o   (per_rdata),
    .leds_o    (o_LED),
    .btn_i     (i_Switch),
    .seg1_o    (seg1),
    .seg2_o    (seg2)
  );

  // SPI Slave
  pochoco_spi_slave u_spi (
    .clk_i      (clk),
    .rst_ni     (rst_ni),
    .sel_i      (spi_sel),
    .req_i      (spi_req),
    .we_i       (data_we),
    .addr_i     (data_addr[7:0]),
    .wdata_i    (data_wdata),
    .rdata_o    (spi_rdata),
    .spi_sclk_i (i_SPI_SCLK),
    .spi_mosi_i (i_SPI_MOSI),
    .spi_cs_n_i (i_SPI_CS_n),
    .spi_miso_o (o_SPI_MISO)
  );

  // 7-seg outputs are active high; board-specific polarity is up to the top
  assign {o_Segment1_G, o_Segment1_F, o_Segment1_E, o_Segment1_D,
          o_Segment1_C, o_Segment1_B, o_Segment1_A} = seg1;
  assign {o_Segment2_G, o_Segment2_F, o_Segment2_E, o_Segment2_D,
          o_Segment2_C, o_Segment2_B, o_Segment2_A} = seg2;

endmodule
