Sarnolds18/Proyecto_2_Arqui/(commit log)

2026-09-25 assembler file :ongod
2026-09-25 avance parseador parsero de parsias
2026-09-25 assemble instruction, corte avengers siono
2026-09-27 contador de ciclos en el periph (offset 0x0C) + testbench + doc en el README
2026-09-27 game_top.v, conecta el soc a la placa de una
2026-09-28 Test Assembler y Readme actualizado
2026-10-26 docs: instalacion de librelane y versiones
2026-10-30 corrida 01: evidencia de readmemh, initial, por_cnt y bram
2026-10-30 sdc propio y scripts de barrido y metricas
2026-10-30 sincronizador de botones y evidencia corrida 02
2026-10-30 interfaz de rom, rom provisoria y primera corrida completa
2026-10-30 fijar version de librelane 3.0.16
2026-11-01 assembler genera rom combinacional
2026-11-01 conteo de palabras de instruccion y datos
2026-11-01 constantes de game.s para 10 MHz
2026-11-01 estrategias de memoria: rom y flip-flops
2026-11-01 pines por funcion y barrido de utilizacion
2026-11-01 contador de ciclos como modulo propio
2026-11-01 analisis de ruta critica
2026-11-01 script de analisis de sintesis jerarquico
2026-11-01 barrido de clock period
2026-11-01 optimizacion de la ruta critica
2026-11-01 costo exacto en el barrido de floorplan
2026-11-01 corridas de comparacion de memoria rom y ff
2026-11-01 sintesis para la simulacion post-sintesis
2026-11-01 signoff: klayout drc y sin celdas de retardo
2026-11-01 resumen de signoff: drc, lvs, antena y slew
2026-11-01 registro de decisiones, secciones 3.1/3.6 y figura de antenas
2026-11-01 memoria ff: indice de 7 bits (widthtrunc)
2026-11-01 comparacion de estrategias de memoria
2026-11-01 simulacion post-sintesis: resultado y config igual a la final
2026-11-02 barrido de utilizacion con el rtl final
2026-11-02 sintesis para la simulacion post-sintesis con el rtl final
2026-11-02 nota: flujo de rom provisoria obsoleto
2026-11-02 analisis de sintesis jerarquico y readme con corrida final
2026-11-02 barrido de clock period con la configuracion final
2026-11-02 simulacion post-sintesis: resultado de sim2 con el rtl final
2026-11-02 bloques.csv de las capturas (excepcion en gitignore)
2026-11-02 informe: corregir conteo de violaciones de antena en 3.2
2026-11-02 nombres de informes: Informe_proyecto2 y Informe_proyecto3
2026-11-02 barrido de clock period: punto de 30 ns con margen
2026-11-02 barrido de clock period: 30 ns en timing e informe
2026-11-02 informe del proyecto 3 en pdf y correccion de alcance en 3.7
2026-11-02 portada del informe como la del proyecto 2
2026-11-03 decisiones: barrido de periodo hecho
